Dark-Science/DecaligoConsilideon-0/README.md

# Decaligo Consilideon Project 0

Projectile motion simulations in GNU Octave for modular prototyping.  
Check project progress [here](https://github.com/Dark-Science/DecaligoConsilideon-0/wiki/Decaligo-Consilideon-%E2%80%90-Project-0 "Project Overview & WBS").

**__Warning:__** The Decaligo Consilideon is an ongoing engienering journal, meaning nothing is concrete yet and every page primarily serves as referrable scratch paper. The more accurate info is included in project reports and the wiki.
