Dark-Science/DecaligoConsilideon-0/Decaligo_Proj0_Ini1/Prototype01/Prototype01_Rendering_20251220.png

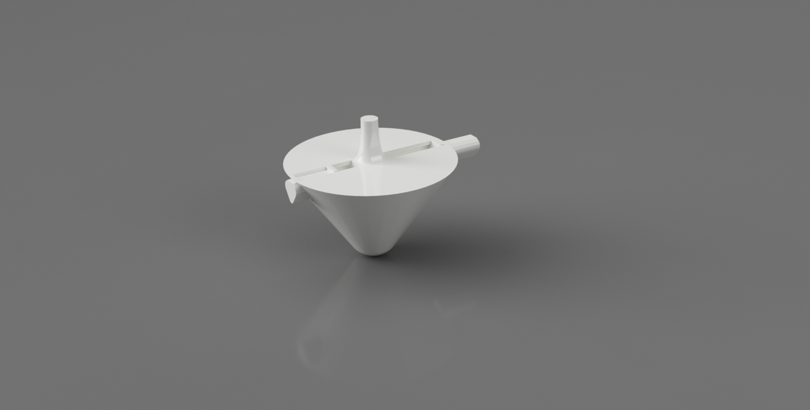
Decaligo_Proj0_Ini1/Prototype01/Prototype01_Rendering_20251220.png
