Dark-Science/DecaligoConsilideon-0/Decaligo_Proj0_Ini1/Prototype01/Prototype01_vA_Capture.png

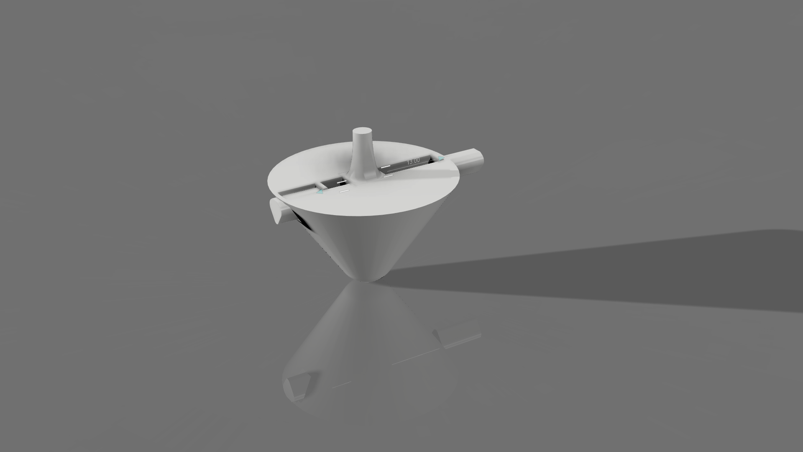
Decaligo_Proj0_Ini1/Prototype01/Prototype01_vA_Capture.png
