Dark-Science/DecaligoConsilideon-0/Decaligo_Proj0_Ini1/Prototype01/Preto_1b_Arm_a3.3mf

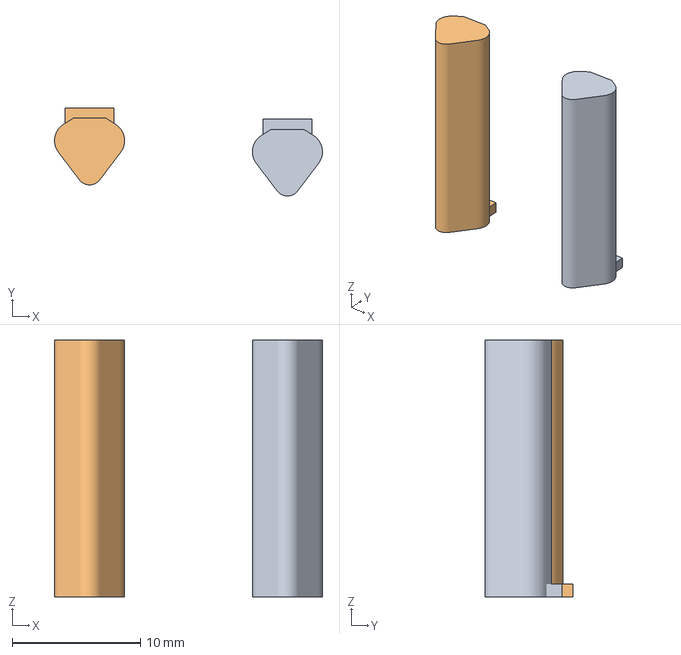
[picture p11: CAD file, 2025-12-23]
Decaligo_Proj0_Ini1/Prototype01/Preto_1b_Arm_a3.3mf
20.9 x 6.87 x 20.0 mm
