Dark-Science/DecaligoConsilideon-0/Decaligo_Proj0_Ini1/Prototype01/Preto_1b v6.3mf

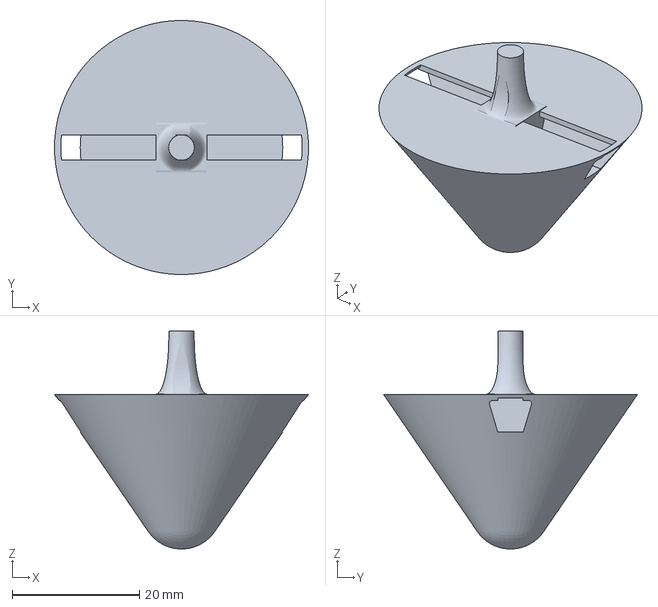
[picture p12: CAD file, 2025-12-23]
Decaligo_Proj0_Ini1/Prototype01/Preto_1b v6.3mf
40.0 x 40.0 x 34.3 mm
