Dark-Science/DecaligoConsilideon-0/Decaligo_Proj0_Ini1/Prototype01/Preto_1b_Arm_a2.3mf

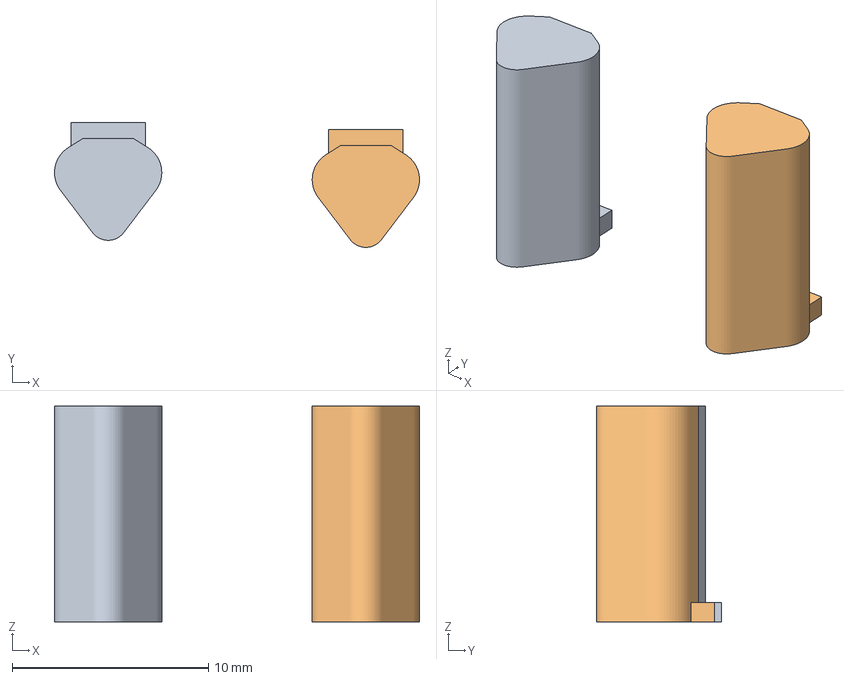
[picture p13: CAD file, 2025-12-23]
Decaligo_Proj0_Ini1/Prototype01/Preto_1b_Arm_a2.3mf
18.6 x 6.36 x 11.0 mm
