Dark-Science/DecaligoConsilideon-0/Decaligo_Proj0_Ini1/Prototype01/Preto_1b_Arm_a.3mf

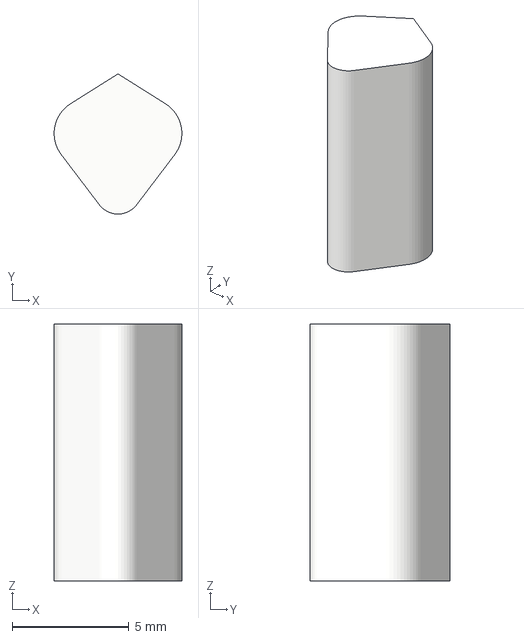
[picture p14: CAD file, 2025-12-21]
Decaligo_Proj0_Ini1/Prototype01/Preto_1b_Arm_a.3mf
5.47 x 6.00 x 11.0 mm
