Dark-Science/DecaligoConsilideon-0/Decaligo_Proj0_Ini1/Prototype01/Preto_1a.3mf

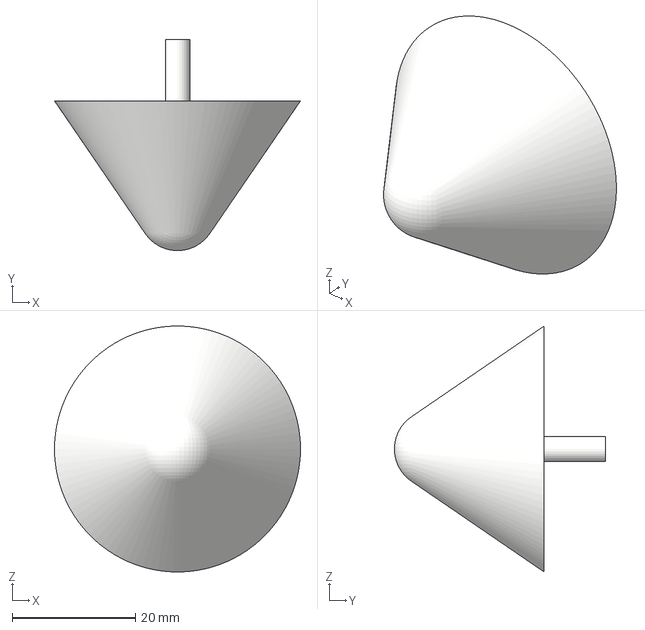
[picture p16: CAD file, 2025-12-20]
Decaligo_Proj0_Ini1/Prototype01/Preto_1a.3mf
40.0 x 34.3 x 40.0 mm
