Dark-Science/DecaligoConsilideon-0/Decaligo_Proj0_Ini1/Prototype00/PreliminarySTEPfiles/shaftandconnector_07_1.stp

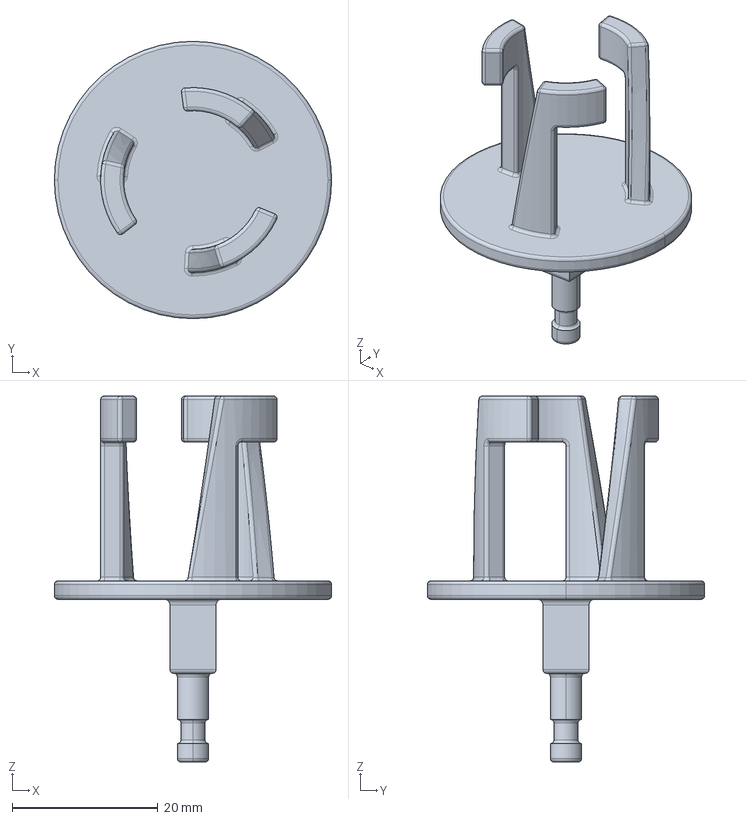
[picture p17: CAD file, 2025-12-20, an earlier design]
Decaligo_Proj0_Ini1/Prototype00/PreliminarySTEPfiles/shaftandconnector_07_1.stp
38.1 x 38.1 x 50.3 mm
