Dark-Science/DecaligoConsilideon-0/Decaligo_Proj0_Ini1/Prototype00/PreliminarySTEPfiles/rack_07_1.stp

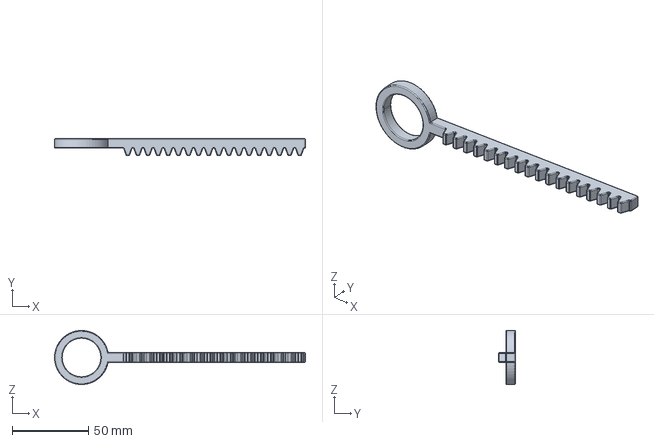
[picture p18: CAD file, 2025-12-20, an earlier design]
Decaligo_Proj0_Ini1/Prototype00/PreliminarySTEPfiles/rack_07_1.stp
165.1 x 11.1 x 35.5 mm
