Dark-Science/DecaligoConsilideon-0/Decaligo_Proj0_Ini1/Prototype00/PreliminarySTEPfiles/steelbearing_7-32in_arm_07_0.stp

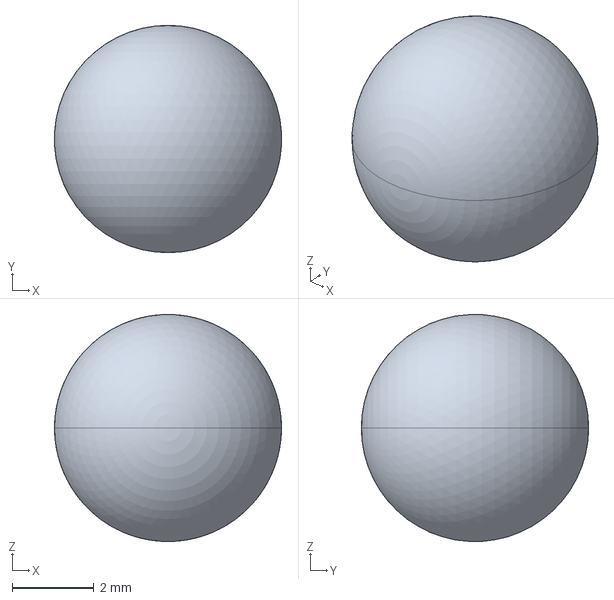
[picture p19: CAD file, 2025-12-20, an earlier design]
Decaligo_Proj0_Ini1/Prototype00/PreliminarySTEPfiles/steelbearing_7-32in_arm_07_0.stp
5.55 x 5.56 x 5.55 mm
