Dark-Science/DecaligoConsilideon-0/Decaligo_Proj0_Ini1/Prototype00/PreliminarySTEPfiles/mount_07_1.stp

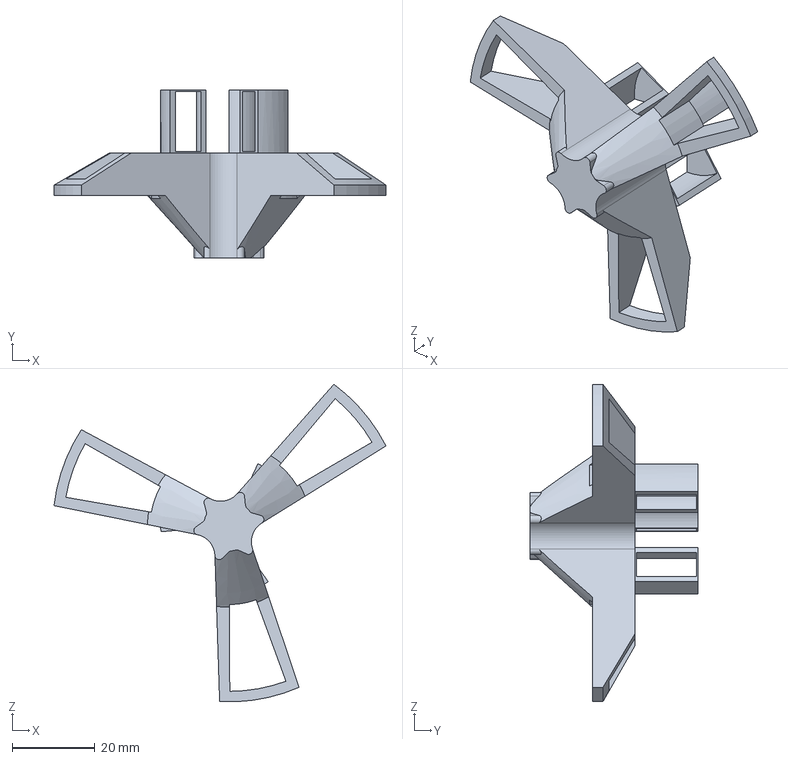
[picture p20: CAD file, 2025-12-20, an earlier design]
Decaligo_Proj0_Ini1/Prototype00/PreliminarySTEPfiles/mount_07_1.stp
80.2 x 40.6 x 76.7 mm
