Dark-Science/DecaligoConsilideon-0/Decaligo_Proj0_Ini1/Prototype00/PreliminarySTEPfiles/gear_07_1.stp

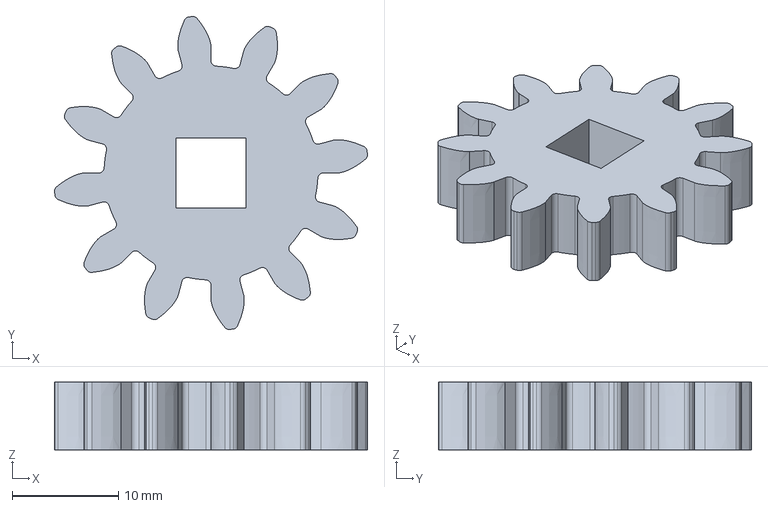
[picture p21: CAD file, 2025-12-20, an earlier design]
Decaligo_Proj0_Ini1/Prototype00/PreliminarySTEPfiles/gear_07_1.stp
29.4 x 29.4 x 6.35 mm
