Dark-Science/DecaligoConsilideon-0/Decaligo_Proj0_Ini1/Prototype00/PreliminarySTEPfiles/steelbearing_05in_apex_07_0.stp

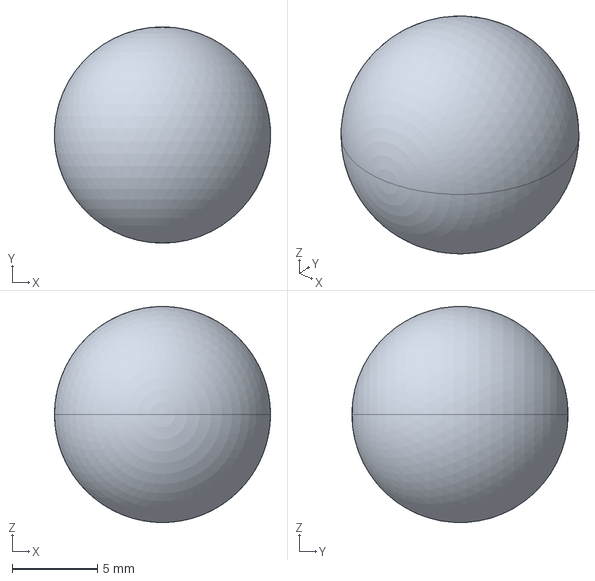
[picture p25: CAD file, 2025-12-20, an earlier design]
Decaligo_Proj0_Ini1/Prototype00/PreliminarySTEPfiles/steelbearing_05in_apex_07_0.stp
12.7 x 12.7 x 12.7 mm
