Dark-Science/DecaligoConsilideon-0/(list of files, cad)

Other CAD files:
Decaligo_Proj0_Ini1/Prototype01/Preto_1b v5.3mf
Decaligo_Proj0_Ini1/Prototype01/Preto_1b.3mf
