Dark-Science/DecaligoConsilideon-0/Decaligo_Proj0_Ini0/DecaligoConsilideon_Proj0_Ini0_ProjectileMotion+WBS.pdf

Before moving on to code (formalization), we need to define what we're plotting. While we have our functions (possible output parameters), we still need to define our input parameters and distinguish measured vs controlled inputs.

In simulation, time can be treated as a control and, in most cases, can be treated as a constant rate which is ideal for the independent (horizontal on graph) component for plotted data. The angle, programmed as either a function of time or as the function of a different function of time relating to the same particle, can work as both an output and measured input which is useful for validation.

This can be looped W.R.T. both time & theta without additional paper proofs.

08/19/2025

# Project 0 Theory: Projectile Motion *

Assuming that the only external forces | felt by the particle are that from pravity and of what propelled the particle into
the dir ms | initially Sketched on | theimplifies its moder of analysis to what is
Fo | F
This model marks the | opening analysis for | the quantification
e | ↓
x for numerous | fields from archery and athletics to | rocket science,
video
games,

and targetting systems.
Before to : | F = Folt), | launch

F = COSA.

VoFD | Do =O the instant t = know = to
At: | V== X, Es= | Recall Unit Circle
# y = 0

, 0 | =Vo COSto , Yo = VoSiNo | x=const

F = -

mgy | Vo = | X. + yo | (xolt =Solx
Letfo,
to, Yeste , to , m,
g =

given

| >Determined by launch Foot | x2-X=
= | Xtz-Xt
Assuming near | Earth's surface,
| Fome | Ax = XSt
g = 9.84(/52) | | X = x(t) = X(t ⁻
+b) ⁺
Xo
| Fodts = MoVo, linear dylo | = (xolt
Let's model the below: | dV. = Launch V diff.
F(t) = Fx x + Fyy (N) | ato-Launch t diff. | y= | Useful if 0 = A(t) is | knowngivencontrolled
π(t) = Xi + ijj (m(52) | =
Y(t) = Xi +
to -ti | (dy =Sydt | -
yj(n(s) | -
| Assume givenNo | YeYe =

# (((to-t) ⁺

### Pet = (Usinedt

F(t) = Xi +
yy(m) | for now | Dy =

(d(t)dt ⁺ )yedt , % swaps signs of t =
te
| | ye =

y(ti+p)
F(t) = 0 -
mg) | A = A(t) | I

=

YoSt ⁻

Eg(t)2 ⁺ Yo | Ato-te-to -
F = | Md | V =
VCOSATVSInDy | · Yp = y(t=
+ p) | Yaax = Ye(t =
to)
-(t) = 0 -
gy | =

xi +
y | = y = = Yz | =

Ye(t =
tp)
[ | y =

## g(to-

t) ⁺
| | Yo | | | | | yz =

## y(t)tp)

=arctan()Fomn | = y ⁻

## YoSt-g(bt)2 g(to-

t) + yo =VSinD
| | Y
If = const. | Y | V== | Continuing analysis sint | here is | much quicker x= = 0 | X = Const. | Via | simulations without defining any constraints.
-X= Xe | = Vo COSA.VCOSA | We can | superpose our findings across both math
V =X y = 0 | (theory) & virtual test environments (like Octave ->
Ote | alike before purchasing materials & equipment
y =
-g = | for | constructing prototypes.
dy = -gat
(dy = -Jeet
Yz ⁻

y =

(g +z ⁻

## gtz)

Sy =
p :

(t =

tz)

= y :

(tz ⁻
to
yy =

### g(to-

t) +Y

# Programming (Formalizing) Projectile Motion Ini Trial 0 *

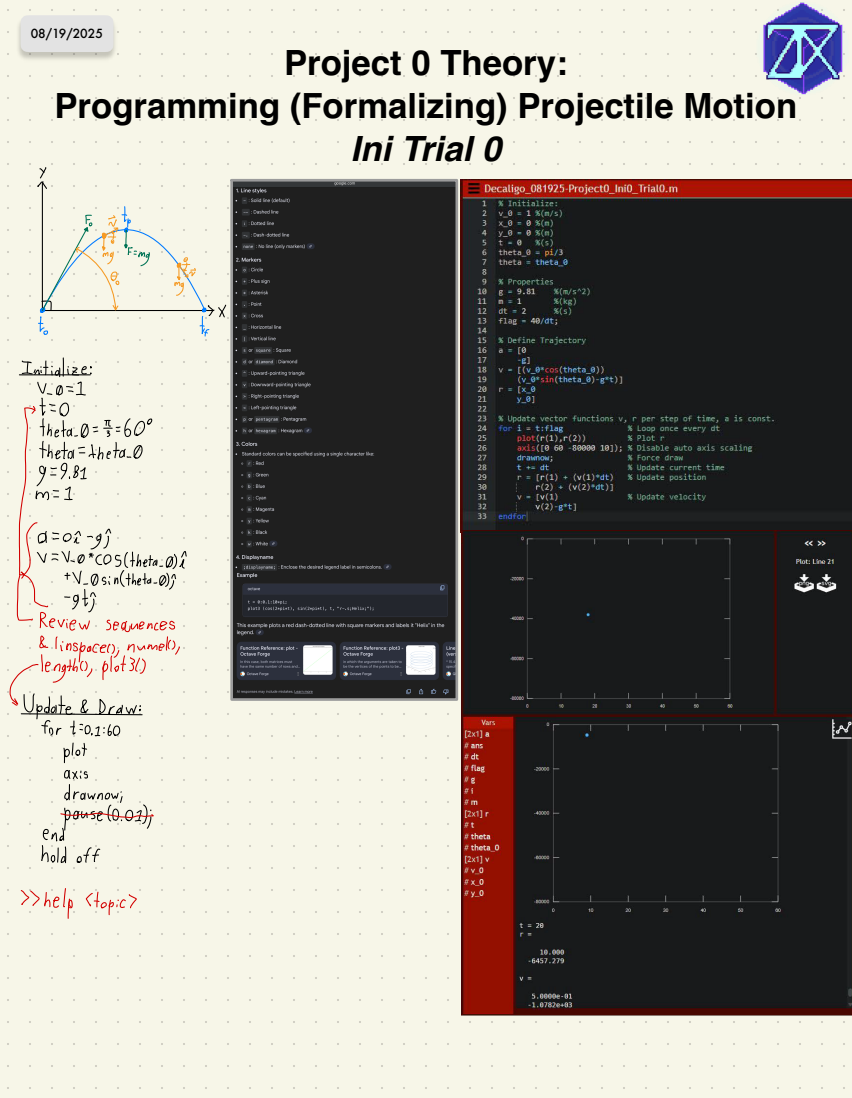
[picture p26: page 2]
msFo; Initialize :; D = 1 t = 0 theta D == 60. thetal = theta-; Gostheti +V_; Osin)theta-Dy [; gty; Review sequences; /inspaces,; numels, SLengthe, plot3) Update & Drawi; for + = 0. 1 : 60 plot; OXIS drawnow;; Mee⁽⁰ .; end hold off; help Stopich

08/25/2025

# To Do:

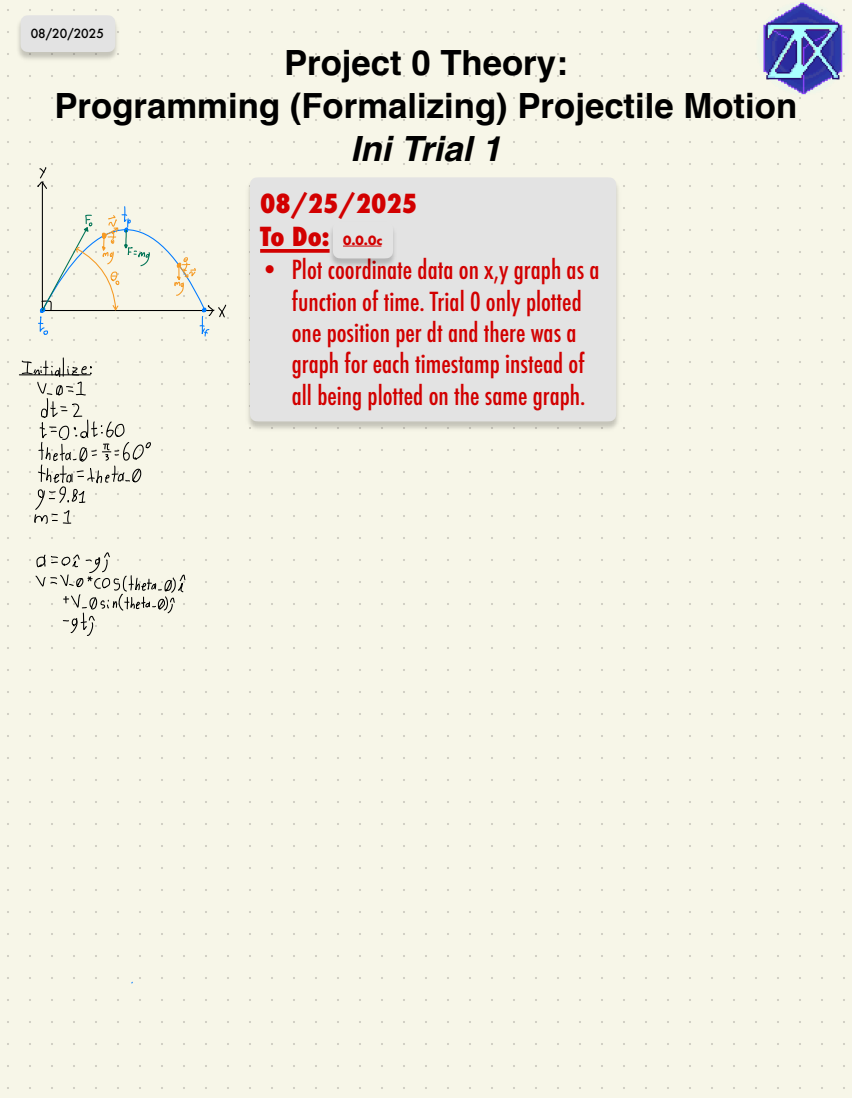
[picture p27: page 3]
msFo; Initialize :; 0 : dt: 60 theta D == 60. thetal = theta-; jy V =Vo + COS(theta-; Osin)theta-Dy -

Programming (Formalizing) Projectile Motion
Ini Trial 1 Y

• Plot coordinate data on x,y graph as a
function of time. Trial 0 only plotted
one position per dt and there was a
graph for each timestamp instead of
all being plotted on the same graph.

Objectives vs Goals:
Goals are typically very
vague while objectives are more specific and provide the scope, function, and
measurement for design &
experimentation

Methods vs Procedures:
Methods analyze the why
and how for the project while the procedure is a more
specific step by step
approach for how to conduct a specific experiment.

Models for Analysis:
- Lift and drag
- Kinematic differential
equations
- Newton's Laws
- Work-energy
- Launch force types
- Force/Area
- State Space Models

Paper math & hand sketches for building the solution

Problem with solution | Computer math & simulate the solution CAD & virtual prototype the solution

Construct and test
physical prototype

List all potential
dangers, risks, and
causes for failure

# Project 0 Initiation: Drafting Project Proposal & Abstract

### Problem Statement

### Objectives

### Motivation

### Methodology

Our reference point, | established as | the starting point for | this
* | traditional projective motion trajectory due to a | launch and the
Force of pravity, has been left open to design consideration.
n | body mechanics to
analysis them on | the preg Fo
e | ↓
x
To quantify | e projectives -The spefordininganthes
to conduct their own | perffelie projects.

& ⁻

# Analyze an introductory model

## 2. Design & analyze various projective launcher apparatuses

3.

### Design & analyze projectile bodies

↑ -

Design & Simulate | Modular Prototype
5 Construct & test | Prototype
Comprehension of this experiment and its theory serves | as | on

# eme

excellent | physicsa new | inventions that
-Theoretical analysis done on | paper employing mathematics and handdrawn schematics
2-theoretical research confirmed via | university provised textbooks & | academic engineering background
3-program& simulate via | GNU Octave

4 -

Define systems, subsystems,

ad properties,
then create | WBS
5-Reiterate steps 2-3 for each subsystem/module | OtherwiseS
or | switch 6-model & test everything in | CAD, | 30 printing pretotypes as | needed | &projects 7.Risk analysis & test plan
8-prototype | Test
& -
Compile formal documentation | -
> | -

## >safely ?

### 10-Present

=

Launcher Ideas:
- Portable vs mounted
- Thrusted into the air by a moving plate/rail
- Spring loaded (linear vs torsion)
- Elastic band (compare to spring loaded) i.e. crossbow, bow
- Velocity from centripetal motion (compare to thrusted into the air)
- Fluid pressure loaded (compare to spring loaded)
- Electromagnetic
- Solenoid (compare to simple electromagnet)

WARNING:
The launcher apparatus will likely inherit friction or other resistances to control and motion that will introduce error in the initial flight conditions if not accounted for.

The control system will need to be designed to take this in account if trajectory accuracy is of concern.

A Sensor System may be needed for developing a targeting control system that ensures a projectile hits a moving target

# Defining the Systems

## The Control System

- Can be human, mechanical, electrical, software, or a combination of such
- This is the system that selects the destination and/or trajectory inputs and ensures the

launcher and its function follow through as intended

- If the launcher is hand held then it is almost certainly driven by a human for its core

control system

- If not portable, will almost certainly be driven by a mechatronic control system driven by

software. This is likely the most useful control system for this experiment

Initiation Model | Aerodynamic Model : | Launch System:
Y | * | Infinite possibilities-,
Categoriz X | needed * How are | we | propelling the projectile into
ms
F

↑ ·

# ing

the dir ?

ne Fo | Fo
e | ↓
x | ↓
x
Initialize : | New Parameters:

V-

D = 1 | C-L = 0 % Lift Coef.
dt = 2 | 21 = 0 % Drag Coef.
t =

0 : dt: 60
theta D == 60. | F =PV2ACr
thetal = theta-
O | Fo =

## EPV2AC

9 = 9 . 84

m = 1

t

a) = 0 -

### jy V =Vo +

COS(theta-

### D) +V_ Osin)theta-Dy -

## gty

↑

# WBS Ini. (Work Breakdown Schedule)

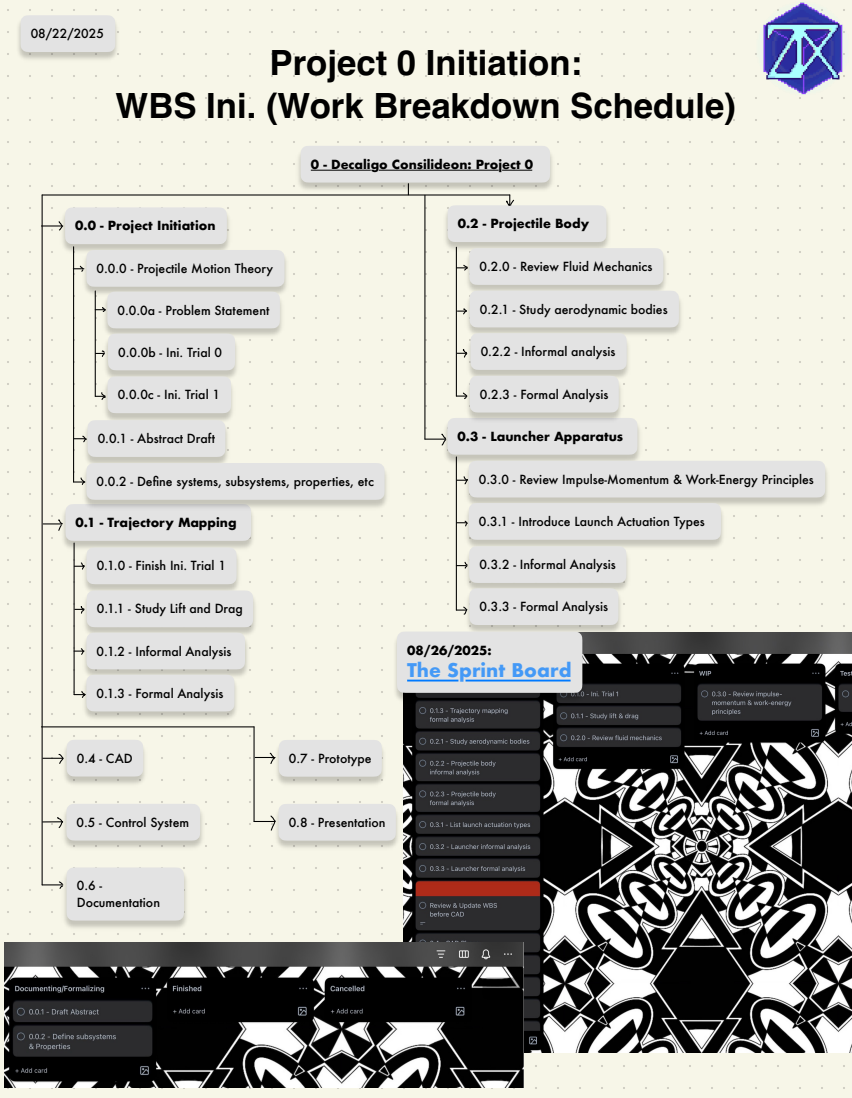
[picture p28: page 6]
0.0 - Project Initiation; 0.1 - Trajectory Mapping; 0.2 - Projectile Body; 0.3 - Launcher Apparatus; 0.6 - Documentation; 0.4 - CAD; 0.5 - Control System; 0.7 - Prototype; 0.8 - Presentation; 0.0.0a - Problem Statement; 0.0.0b - Ini. Trial 0; 0.0.0c - Ini. Trial 1; 0.0.1 - Abstract Draft; 0.1.2 - Informal Analysis; 0.1.3 - Formal Analysis; 0.2.2 - Informal analysis; 0.2.3 - Formal Analysis; 0.3.2 - Informal Analysis; 0.3.3 - Formal Analysis

0 - Decaligo Consilideon: Project 0

0.0.0 - Projectile Motion Theory

0.2.0 - Review Fluid Mechanics

0.2.1 - Study aerodynamic bodies

0.3.0 - Review Impulse-Momentum & Work-Energy Principles

0.0.2 - Define systems, subsystems, properties, etc

0.3.1 - Introduce Launch Actuation Types

0.1.0 - Finish Ini. Trial 1

0.1.1 - Study Lift and Drag

The Sprint Board
