Dark-Science/DecaligoConsilideon-0/(commit log)

2025-12-20 Updated github end
    [Preto_1a.3mf, Preto_1b.3mf, armf_07_3.stp, cone_07_1.stp, gear_07_1.stp, holder_07_1.stp, mount_07_1.stp, rack_07_1.stp]
2025-12-21 3D printing pretotypes for Prototype 1
    "Pretotype" is a newer industry term referring to a miniaturized prototype intended for testing particular subassemblies or features as opposed to having to include them in another prototype which would cost more time and money.
    [Preto_1b v5.3mf, Preto_1b v6.3mf, Preto_1b_Arm_a.3mf, Preto_1b_Arm_a1.3mf, Preto_1b_Arm_a2.3mf]
2025-12-23 Trial and Error Bambu A1 Print Setup
    Difficulties in bed adhesion arise when trying to print the spinning top positioned upright so as to have an infill layout that balances the interior mass distribution. Printing the device upside down only further complicated things despite common intuition. Unfortunately printing right-side up causes an unavoidable rough curvature along the apex but at least the print comes out functional and with very few other much more subtle defects.
    [Preto_1b v6.3mf, Preto_1b_Arm_a2.3mf, Preto_1b_Arm_a3.3mf]
2025-12-24 More organization and uploaded Creo design files for prototype 0
    Current problem:
    - The arms are too snug and do not move, they need to be loosened.
    [Preto_1a.3mf, Preto_1b v5.3mf, Preto_1b v6.3mf, Preto_1b.3mf, Preto_1b_Arm_a.3mf, Preto_1b_Arm_a1.3mf, Preto_1b_Arm_a2.3mf, Preto_1b_Arm_a3.3mf]
